brueter/filament-buffer-cad/cad/array-front-screen.step

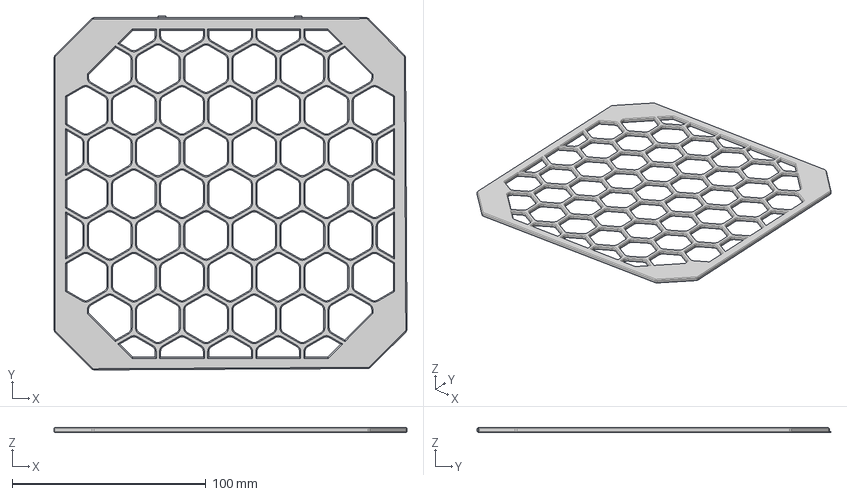
[picture p1: CAD file, 2023-05-08]
cad/array-front-screen.step
182.4 x 182.8 x 2.80 mm
