brueter/filament-buffer-cad/cad/array-latch-12a.step

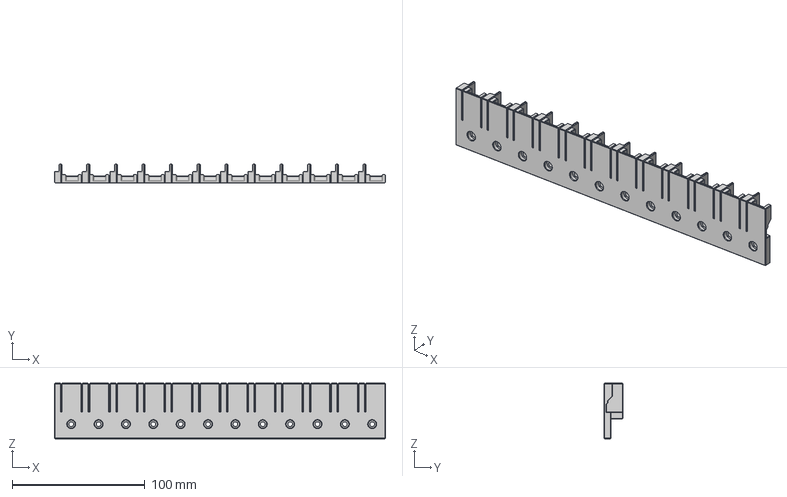
[picture p2: CAD file, 2023-05-08]
cad/array-latch-12a.step
249.2 x 14.0 x 41.8 mm
