brueter/filament-buffer-cad/cad/array-bottom-bracket-6.step

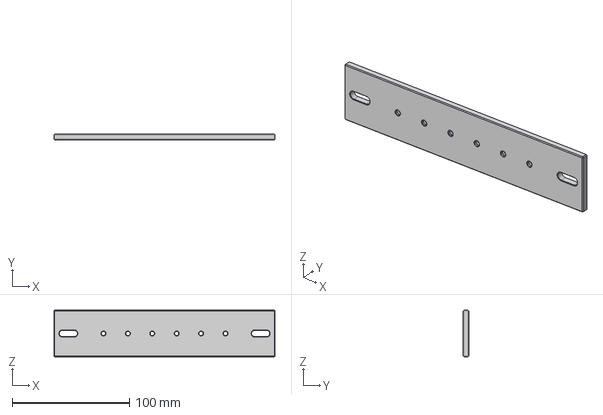
[picture p3: CAD file, 2023-05-08]
cad/array-bottom-bracket-6.step
188.4 x 4.80 x 39.8 mm
