brueter/filament-buffer-cad/cad/array-bottom-bracket-9.step

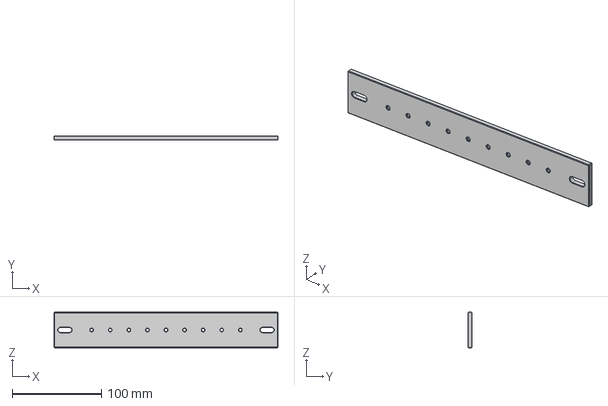
[picture p4: CAD file, 2023-05-08]
cad/array-bottom-bracket-9.step
250.8 x 4.80 x 39.8 mm
