brueter/filament-buffer-cad/cad/array-latch-6b.step

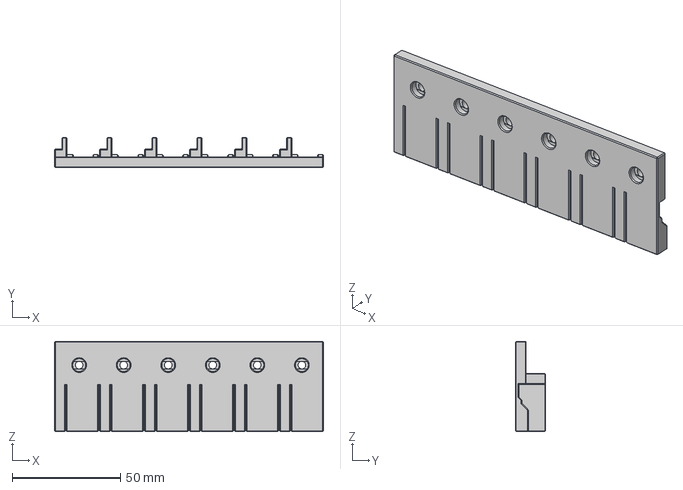
[picture p5: CAD file, 2023-05-08]
cad/array-latch-6b.step
124.4 x 14.0 x 41.8 mm
