brueter/filament-buffer-cad/cad/array-latch-9a.step

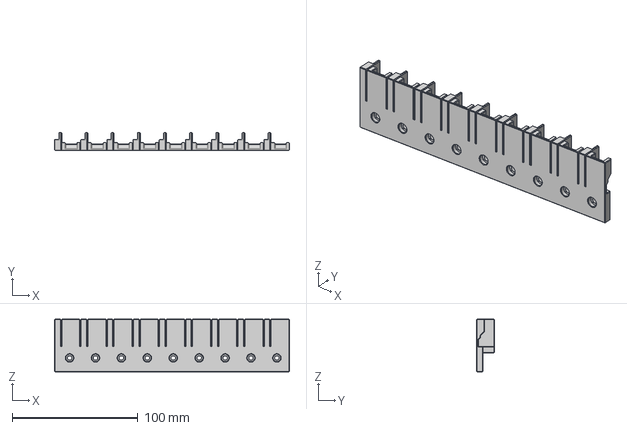
[picture p6: CAD file, 2023-05-08]
cad/array-latch-9a.step
186.8 x 14.0 x 41.8 mm
