brueter/filament-buffer-cad/cad/array-bottom-bracket-12.step

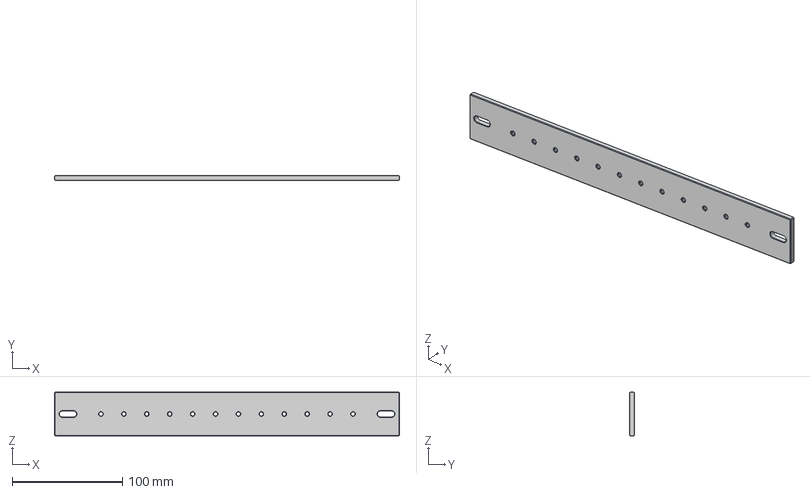
[picture p7: CAD file, 2023-05-08]
cad/array-bottom-bracket-12.step
313.2 x 4.80 x 39.8 mm
