brueter/filament-buffer-cad/cad/buffer-top-magnet+magnet.step

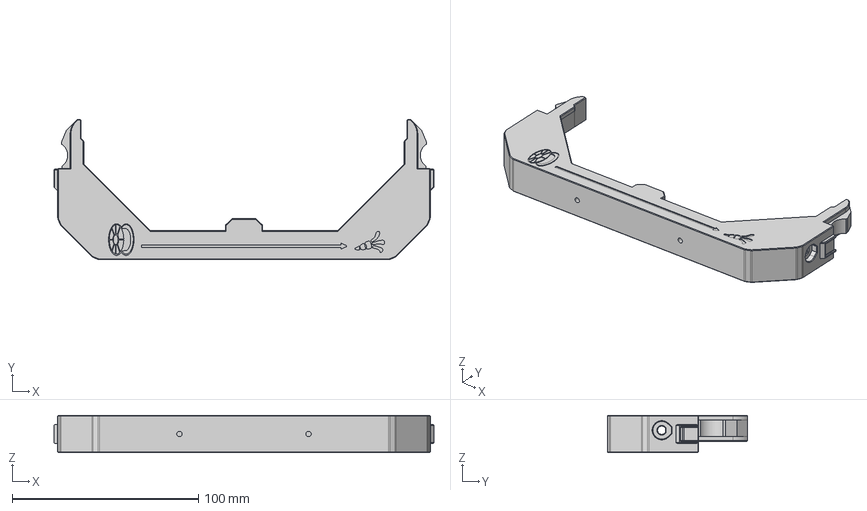
[picture p8: CAD file, 2023-05-07]
cad/buffer-top-magnet+magnet.step
204.0 x 75.4 x 20.0 mm
