brueter/filament-buffer-cad/cad/buffer-bottom.step

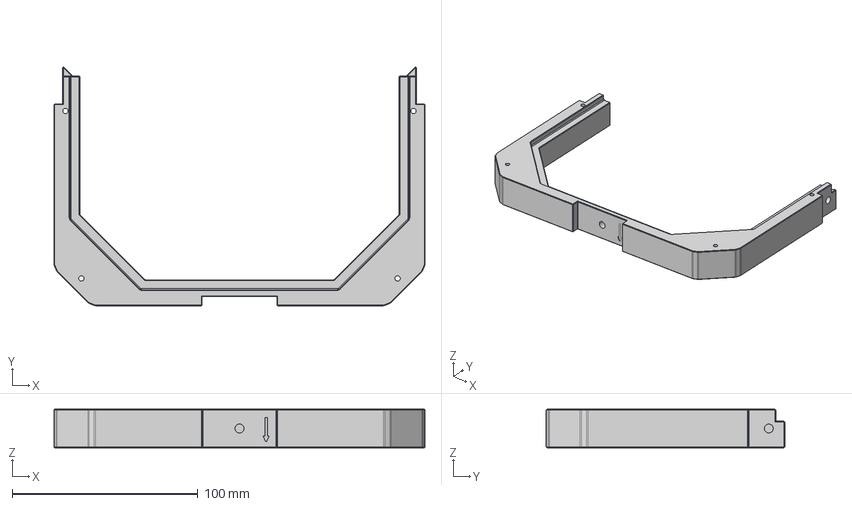
[picture p9: CAD file, 2023-05-07]
cad/buffer-bottom.step
200.0 x 128.6 x 20.8 mm
