brueter/filament-buffer-cad/cad/buffer-screen-a.step

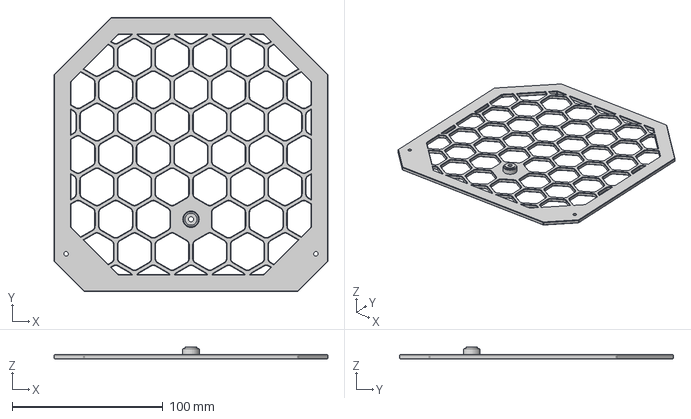
[picture p10: CAD file, 2023-05-07]
cad/buffer-screen-a.step
182.0 x 182.0 x 7.80 mm
