brueter/filament-buffer-cad/cad/buffer-bearing-insert.step

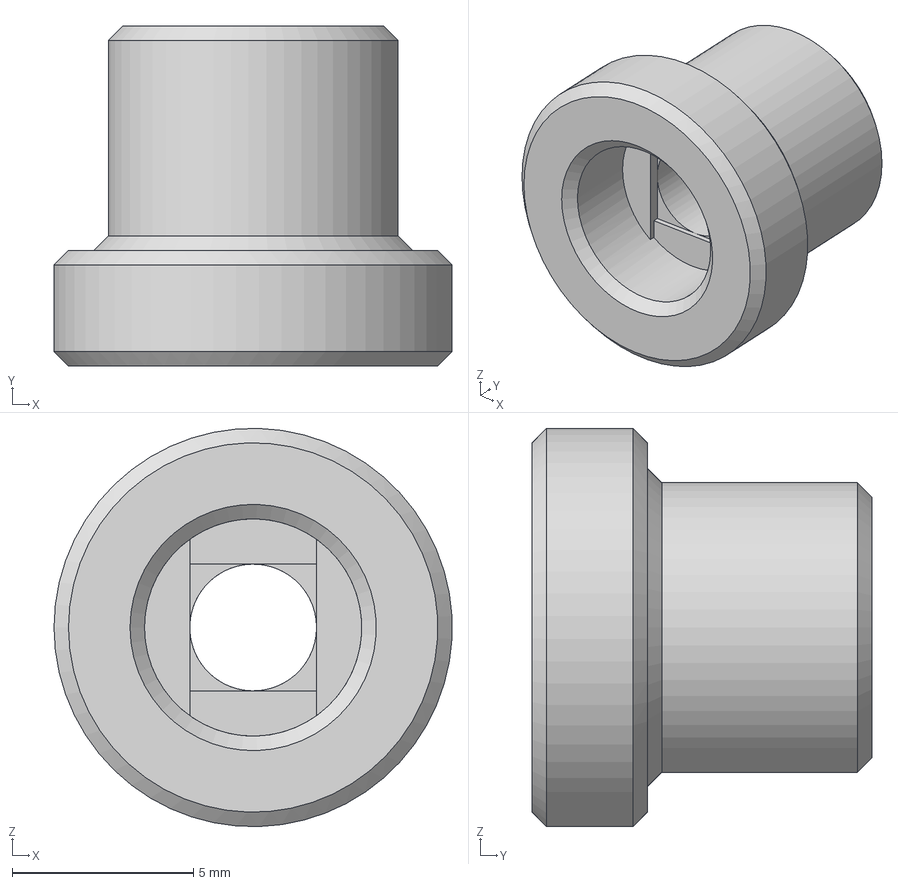
[picture p11: CAD file, 2023-05-06]
cad/buffer-bearing-insert.step
11.0 x 9.40 x 11.0 mm
