brueter/filament-buffer-cad/cad/buffer-screen-b.step

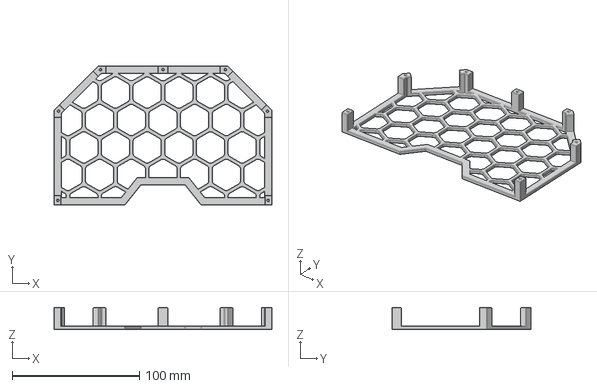
[picture p12: CAD file, 2023-05-06]
cad/buffer-screen-b.step
171.2 x 109.4 x 17.3 mm
