brueter/filament-buffer-cad/cad/array-front.step

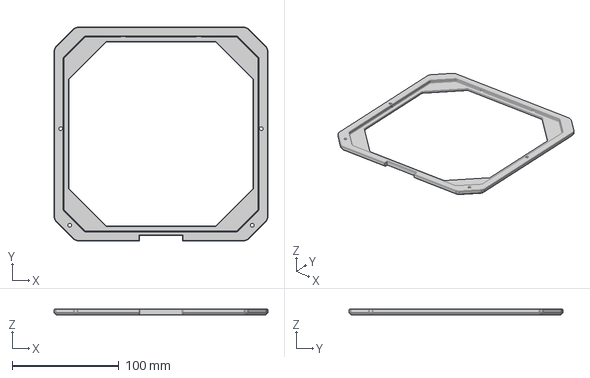
[picture p13: CAD file, 2023-05-06]
cad/array-front.step
200.0 x 200.0 x 5.40 mm
