brueter/filament-buffer-cad/cad/buffer-handle.step

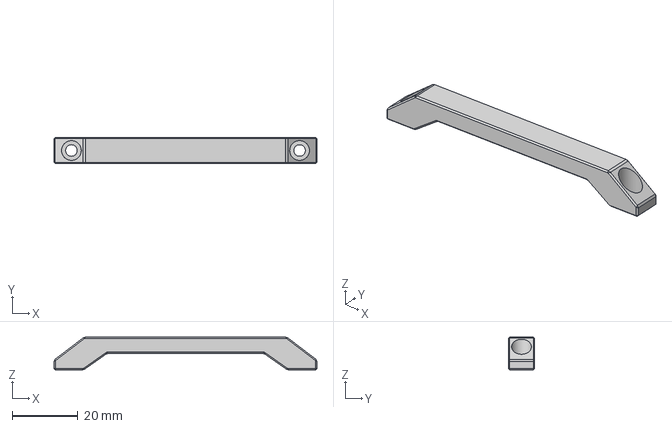
[picture p14: CAD file, 2023-05-06]
cad/buffer-handle.step
80.0 x 8.00 x 10.0 mm
