brueter/filament-buffer-cad/(list of files, cad)

Other CAD files:
cad/array-latch-12b.step
cad/array-latch-9b.step
cad/array-latch-6a.step
cad/array-back.step
cad/parametric/array bottom bracket.f3d
cad/parametric/array latch.f3d
stl/buffer-screen-a.stl
