brueter/filament-buffer-cad/documentation/manual.pdf

### BUFFER SCREEN A

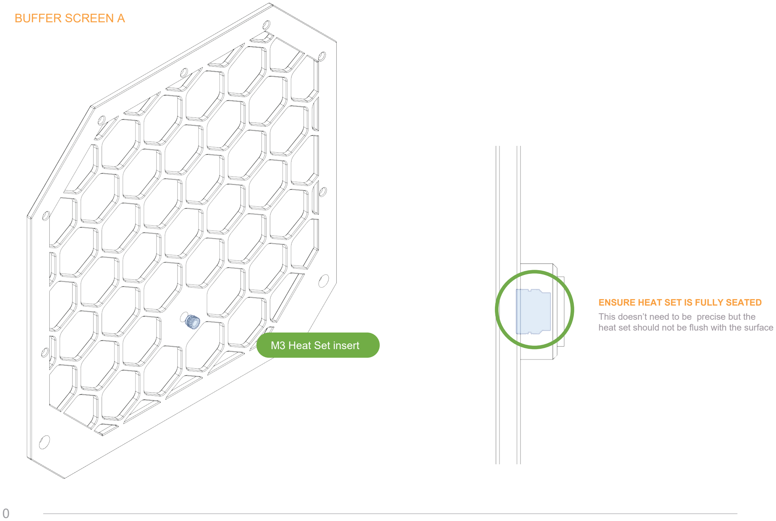
[picture p15: page 1]

0

### M3 Heat Set insert

ENSURE HEAT SET IS FULLY SEATED This doesn’t need to be precise but the heat set should not be flush with the surface

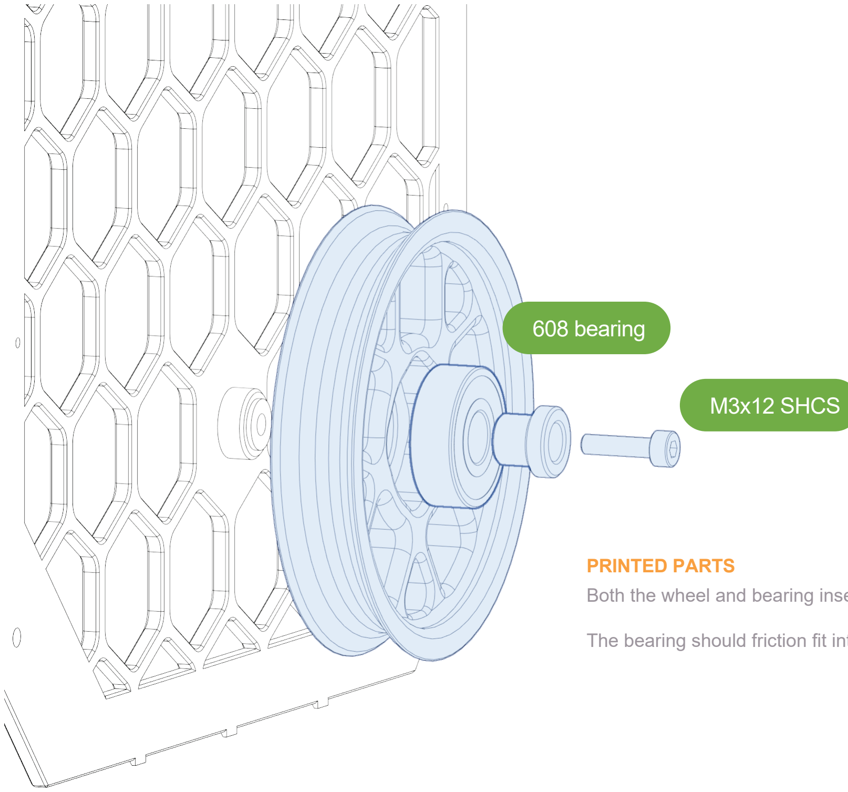
[picture p16: figure]
608 bearing; M3x12 SHCS; PRINTED PARTS

Both the wheel and bearing insert are printed
The bearing should friction fit into the wheel and the bearing insert should not have much play

WHEEL BEHAVIOUR
The wheel should spin fairly freely, it doesn’t exactly have to be a fidget spinner but make sure there isn’t much resistence. If your wheel isn’t turning well check to make sure your heat set is inserted straight by putting a bolt in without the wheel to see if its relatively straight.

0

### BUFFER WHEEL ASSEMBLY

### BUFFER SCREEN

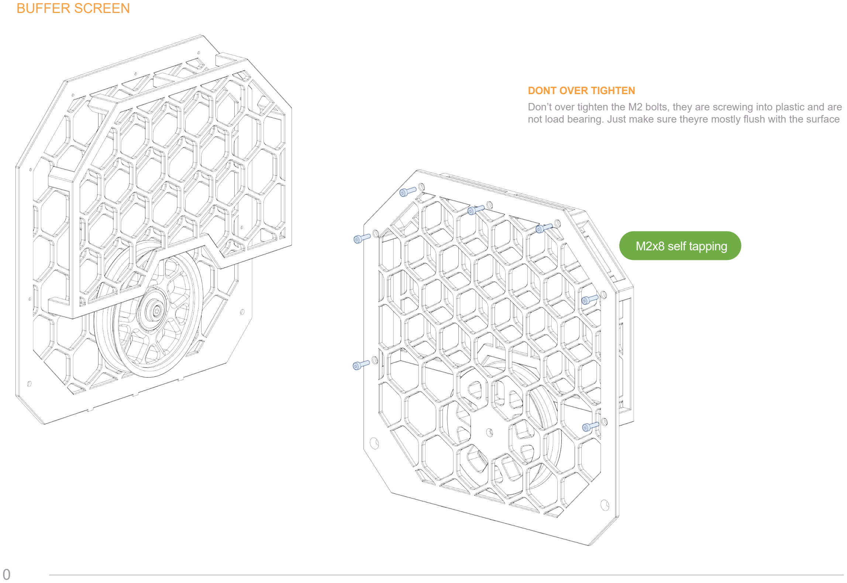
[picture p17: page 3]

### M2x8 self tapping

DONT OVER TIGHTEN
Don’t over tighten the M2 bolts, they are screwing into plastic and are not load bearing. Just make sure theyre mostly flush with the surface

0

### BUFFER TOP

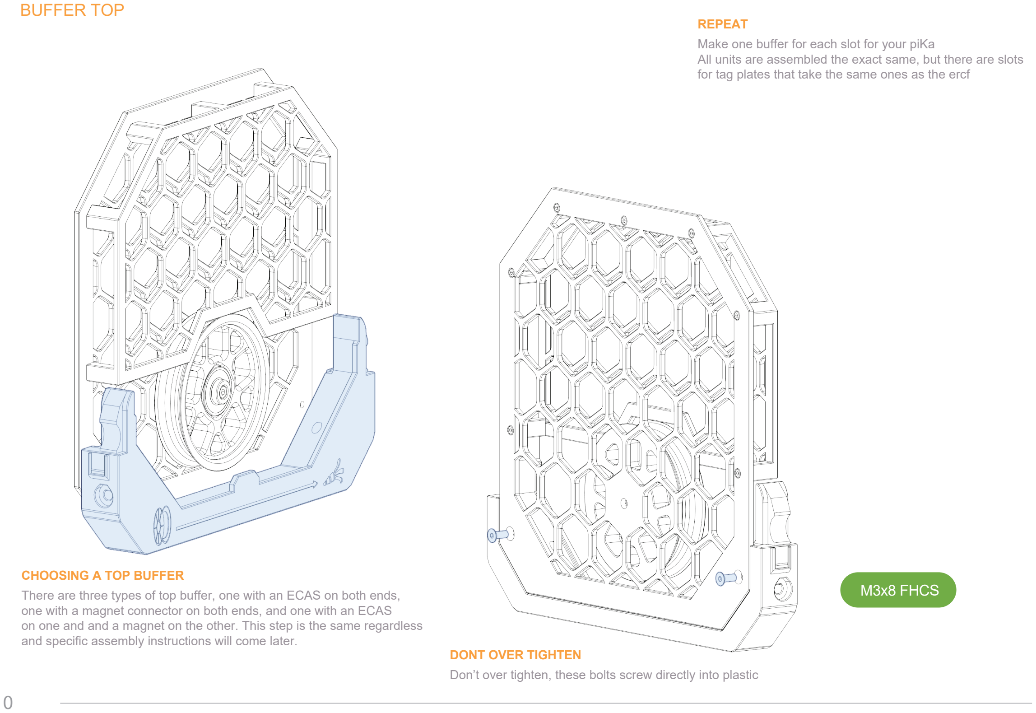
[picture p18: page 4]

DONT OVER TIGHTEN
Don’t over tighten, these bolts screw directly into plastic

CHOOSING A TOP BUFFER
There are three types of top buffer, one with an ECAS on both ends, one with a magnet connector on both ends, and one with an ECAS
on one and and a magnet on the other. This step is the same regardless and specific assembly instructions will come later.

REPEAT
Make one buffer for each slot for your piKa
All units are assembled the exact same, but there are slots for tag plates that take the same ones as the ercf

0

### M3x8 FHCS

### BUFFER BOTTOM

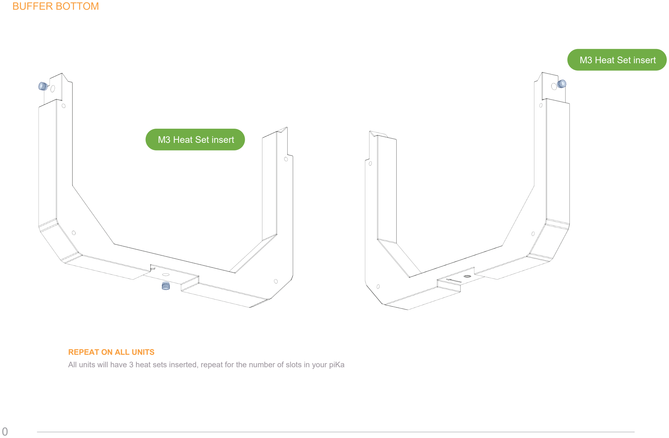
[picture p19: page 5]

REPEAT ON ALL UNITS
All units will have 3 heat sets inserted, repeat for the number of slots in your piKa

0

### M3 Heat Set insert

### M3 Heat Set insert

### LATCHES

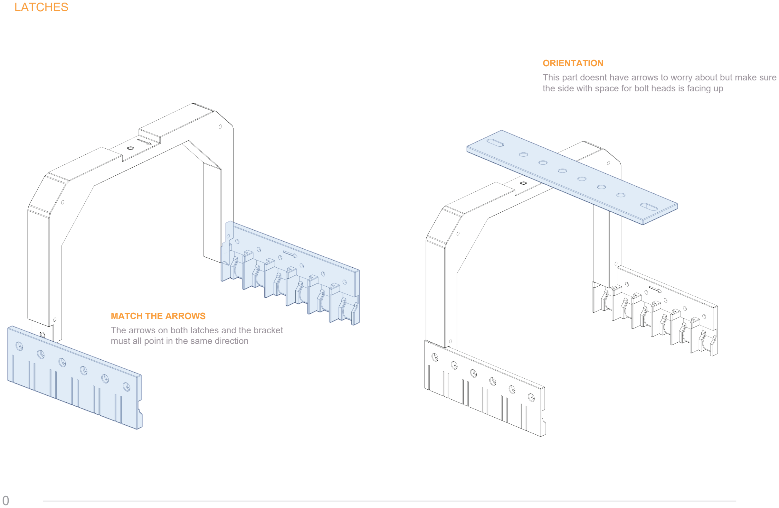
[picture p20: page 6]

MATCH THE ARROWS
The arrows on both latches and the bracket must all point in the same direction

ORIENTATION
This part doesnt have arrows to worry about but make sure the side with space for bolt heads is facing up

0

### HOUSING ASSEMBLY

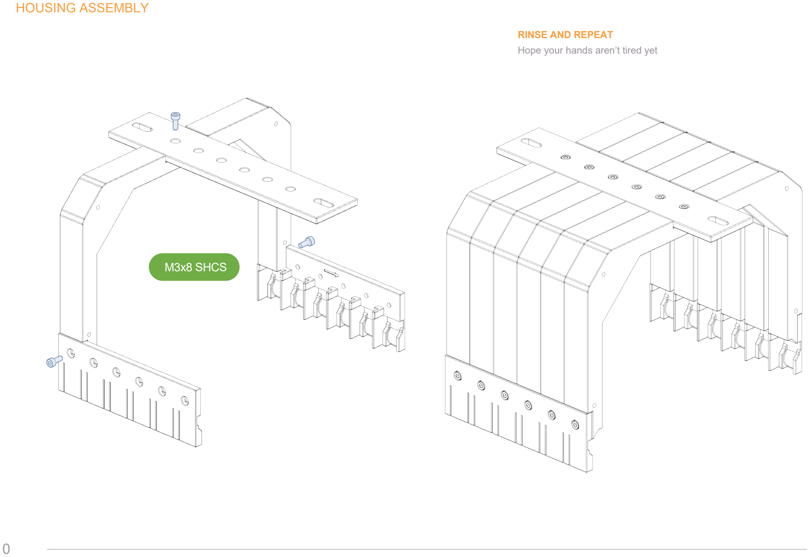
[picture p21: page 7]

RINSE AND REPEAT
Hope your hands aren’t tired yet

0

### M3x8 SHCS

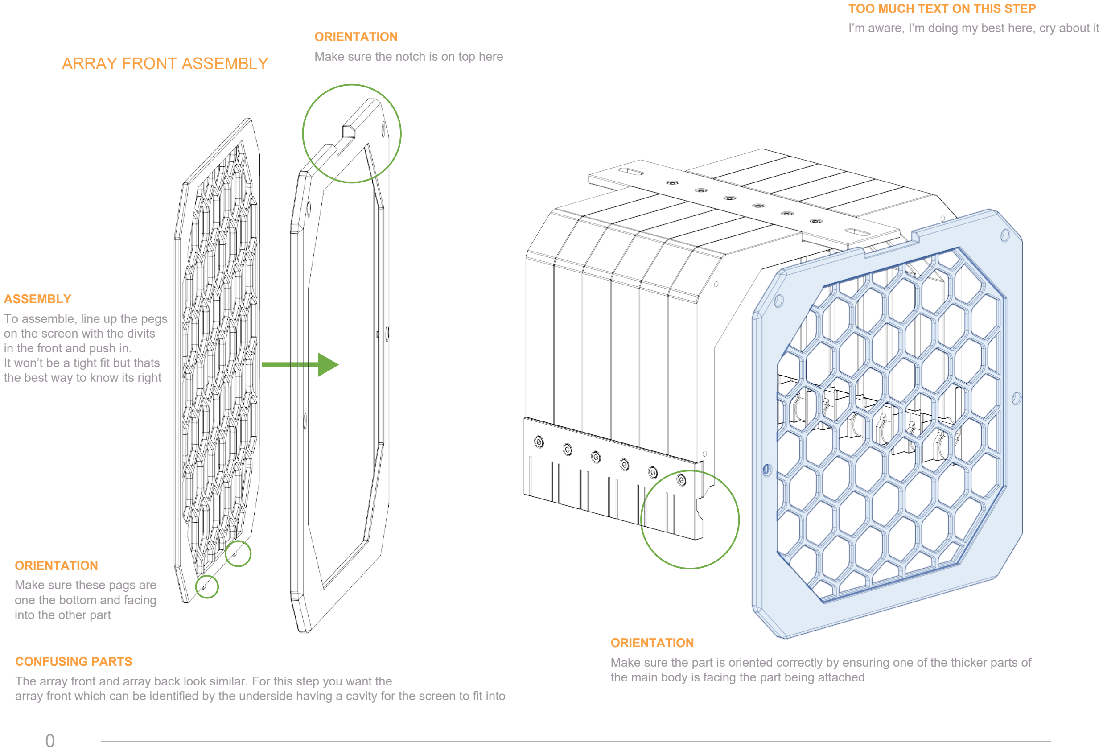
[picture p22: figure]
CONFUSING PARTS; TOO MUCH TEXT ON THIS STEP; ORIENTATION; ORIENTATION Make sure the notch is on top here; ORIENTATION Make sure these pags are one the bottom and facing into the other part; ASSEMBLY To assemble, line up the pegs on the screen with the divits in the front and push in. It won’t be a tight fit but thats the best way to know its right; ARRAY FRONT ASSEMBLY

The array front and array back look similar. For this step you want the
array front which can be identified by the underside having a cavity for the screen to fit into

I’m aware, I’m doing my best here, cry about it

Make sure the part is oriented correctly by ensuring one of the thicker parts of the main body is facing the part being attached

### ARRAY FRONT

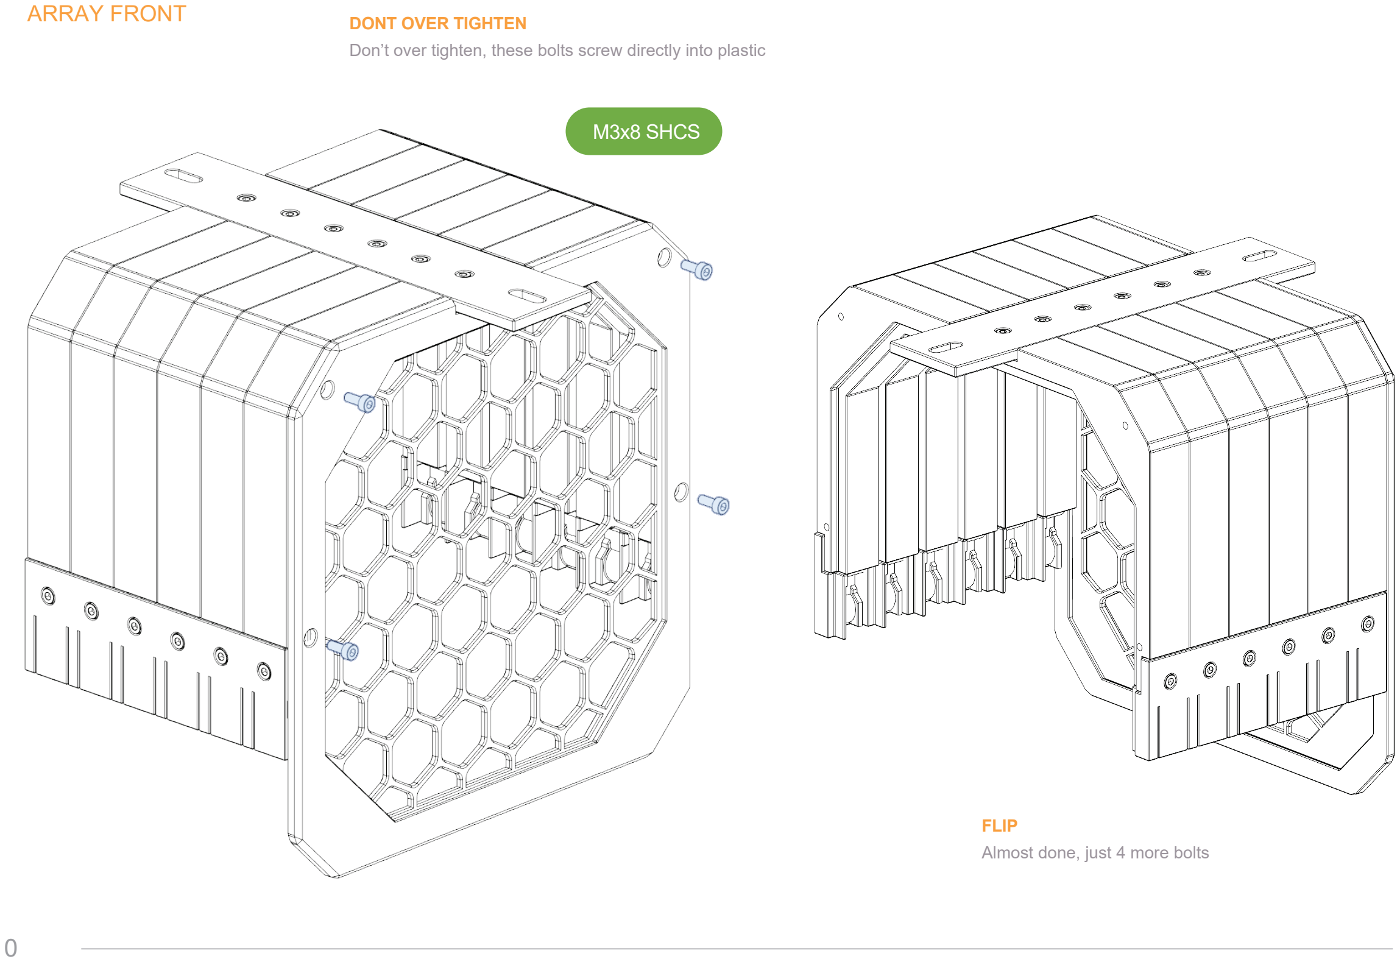
[picture p23: page 9]

DONT OVER TIGHTEN
Don’t over tighten, these bolts screw directly into plastic

FLIP
Almost done, just 4 more bolts

### M3x8 SHCS

0

### ARRAY BACK

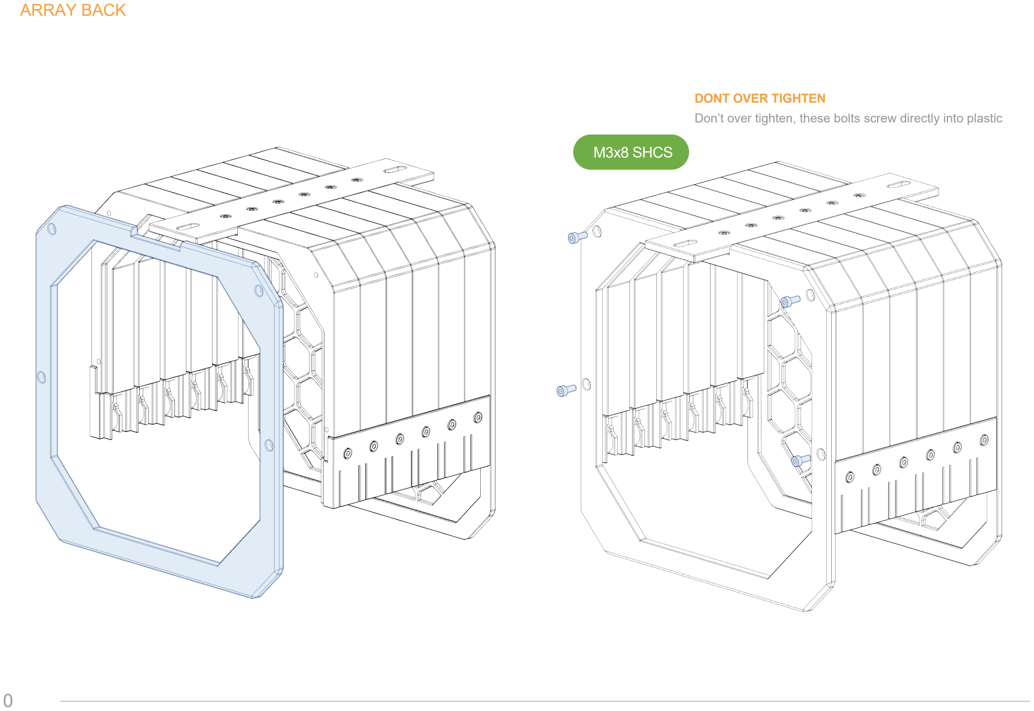
[picture p24: page 10]

DONT OVER TIGHTEN
Don’t over tighten, these bolts screw directly into plastic

### M3x8 SHCS

0
