brueter/filament-buffer-cad/(commit log)

2023-05-06 added cad for array back, array front, buffer handle, buffer screen a, and buffer screen b. also added folders where new manual will be located
    [buffer-screen-a.stl]
2023-05-06 started manual, added buffer bearing insert cad
    [buffer-bearing-insert.step, buffer-handle.step]
2023-05-07 more progress on the manual, added cad for buffer top magnet+magnet
    [buffer-screen-a.step, buffer-screen-a.stl]
2023-05-07 buffer bottom cad
    [buffer-bottom.step, buffer-top-magnet+magnet.step]
2023-05-08 added cad for array latches a and b, and array bottom bracket. f3d files have been added in /cad/parametric so users can modify both of these files by changing one variable
    [array bottom bracket.f3d, array latch.f3d, array-bottom-bracket-12.step, array-bottom-bracket-6.step, array-bottom-bracket-9.step, array-latch-12a.step, array-latch-12b.step, array-latch-6a.step]
2023-05-08 added cad for array front screen and nearly finished the manual, just needs a little more text
    [array-front-screen.step]
